garrettsworkshop/RAMSIMM-30/GW4191-4MB-parity-SOP/Documentation/RearIsom.png

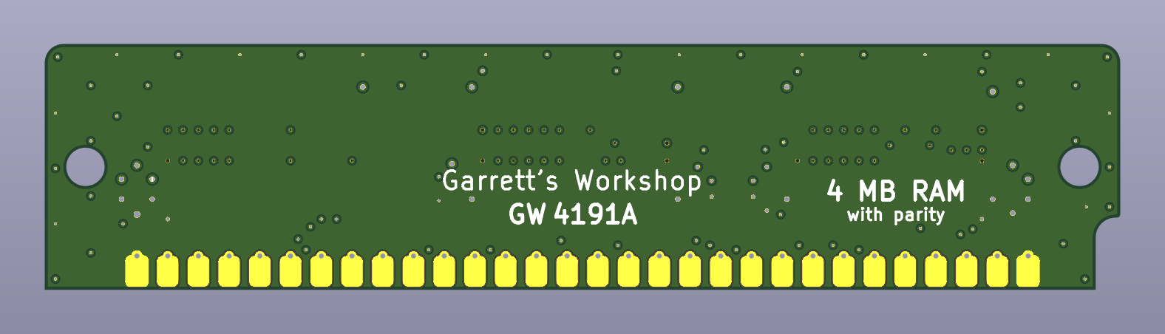
GW4191-4MB-parity-SOP/Documentation/RearIsom.png
