garrettsworkshop/RAMSIMM-30/GW4194-4MB-CBRFIX-SOJ-DP/Documentation/BackIsom.png

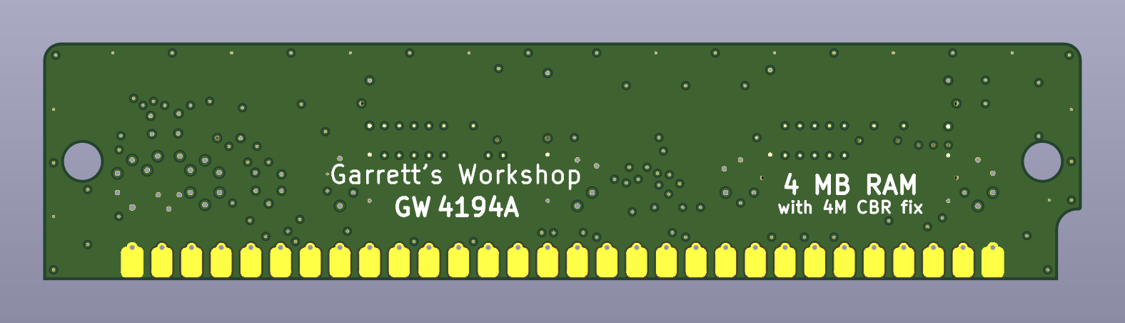
GW4194-4MB-CBRFIX-SOJ-DP/Documentation/BackIsom.png
