garrettsworkshop/RAMSIMM-30/GW4194-4MB-CBRFIX-SOJ-DP/Documentation/FrontIsom.png

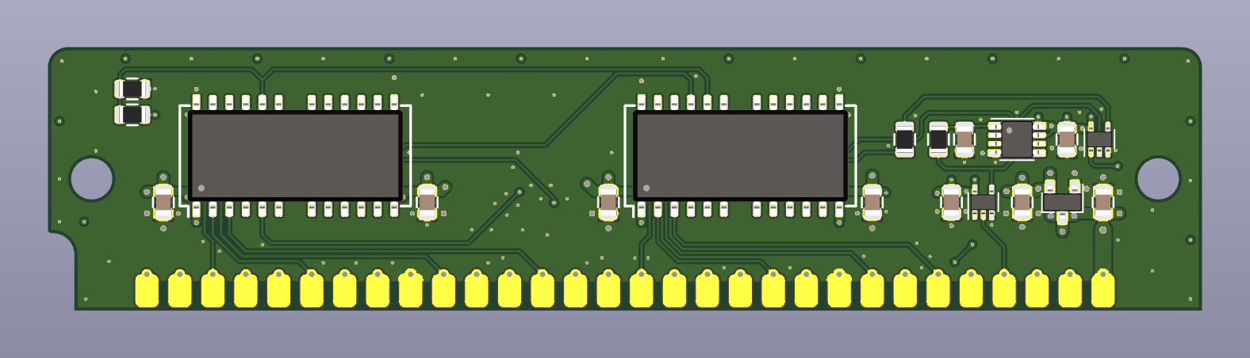
GW4194-4MB-CBRFIX-SOJ-DP/Documentation/FrontIsom.png
