garrettsworkshop/RAMSIMM-30/Documentation/CBR Fix.png

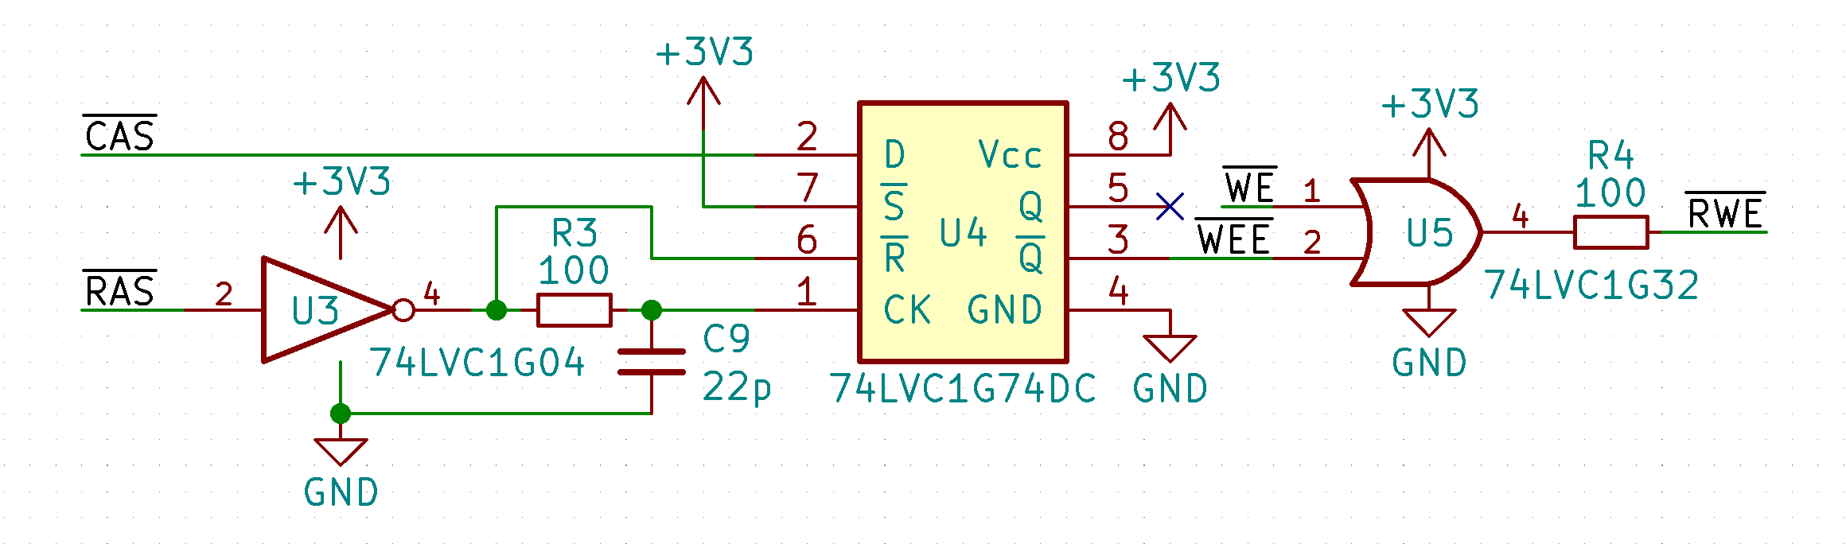
Documentation/CBR Fix.png
