garrettsworkshop/RAMSIMM-30/(threads)

Thread 2 (2022-03-25):

Why some network layer connections do not follow the definition of SIMM pins?

AiGeekNet, 2022-03-25:
I'm trying to print out PIN name on silkscreen layout and copy them from name of network links, and read the history of SIMM from wiki at same time. Then I found there are several different PINs definition just as below:

PIN /  Net Name to IC PINs  / SIMM Definition
==============================
 24 /  1A3            / A11 !!!

 19 /  1A4            / A10 !!!

 18 /  1A5            / A9  !!!

 17 / 1A10            / A8  !!!

 12 /  1A8            / A5  !!!

 11 /  1A9            / A4  !!!

  8 /  1A11           / A3  !!!

Anythings wrong?

AiGeekNet, 2022-04-01:
So mysterious. Is there any good book to learn the complete design specifications and techniques of DRAM modules? I've read a good getting started guide online (https://arstechnica.com/gadgets/2000/07/ram-guide-part1-1/) and would love to dig into some more ^&^

Thread 3 (2022-04-01):

How about higher speed ICs onboard?

AiGeekNet, 2022-04-01:
The ICs I ordered for the first set of four 16MB prototype module is on the way. I can just get 60ns ICs for lowest price, and I just wondered does it work correctly? If I wanna try higher speed ICs such as 50ns, 45ns or 40ns, how much improvement work is needed for these designs of spec?
