garrettsworkshop/RAMSIMM-30/GW4194-4MB-CBRFIX-SOJ-DC/Documentation/Schematic.pdf

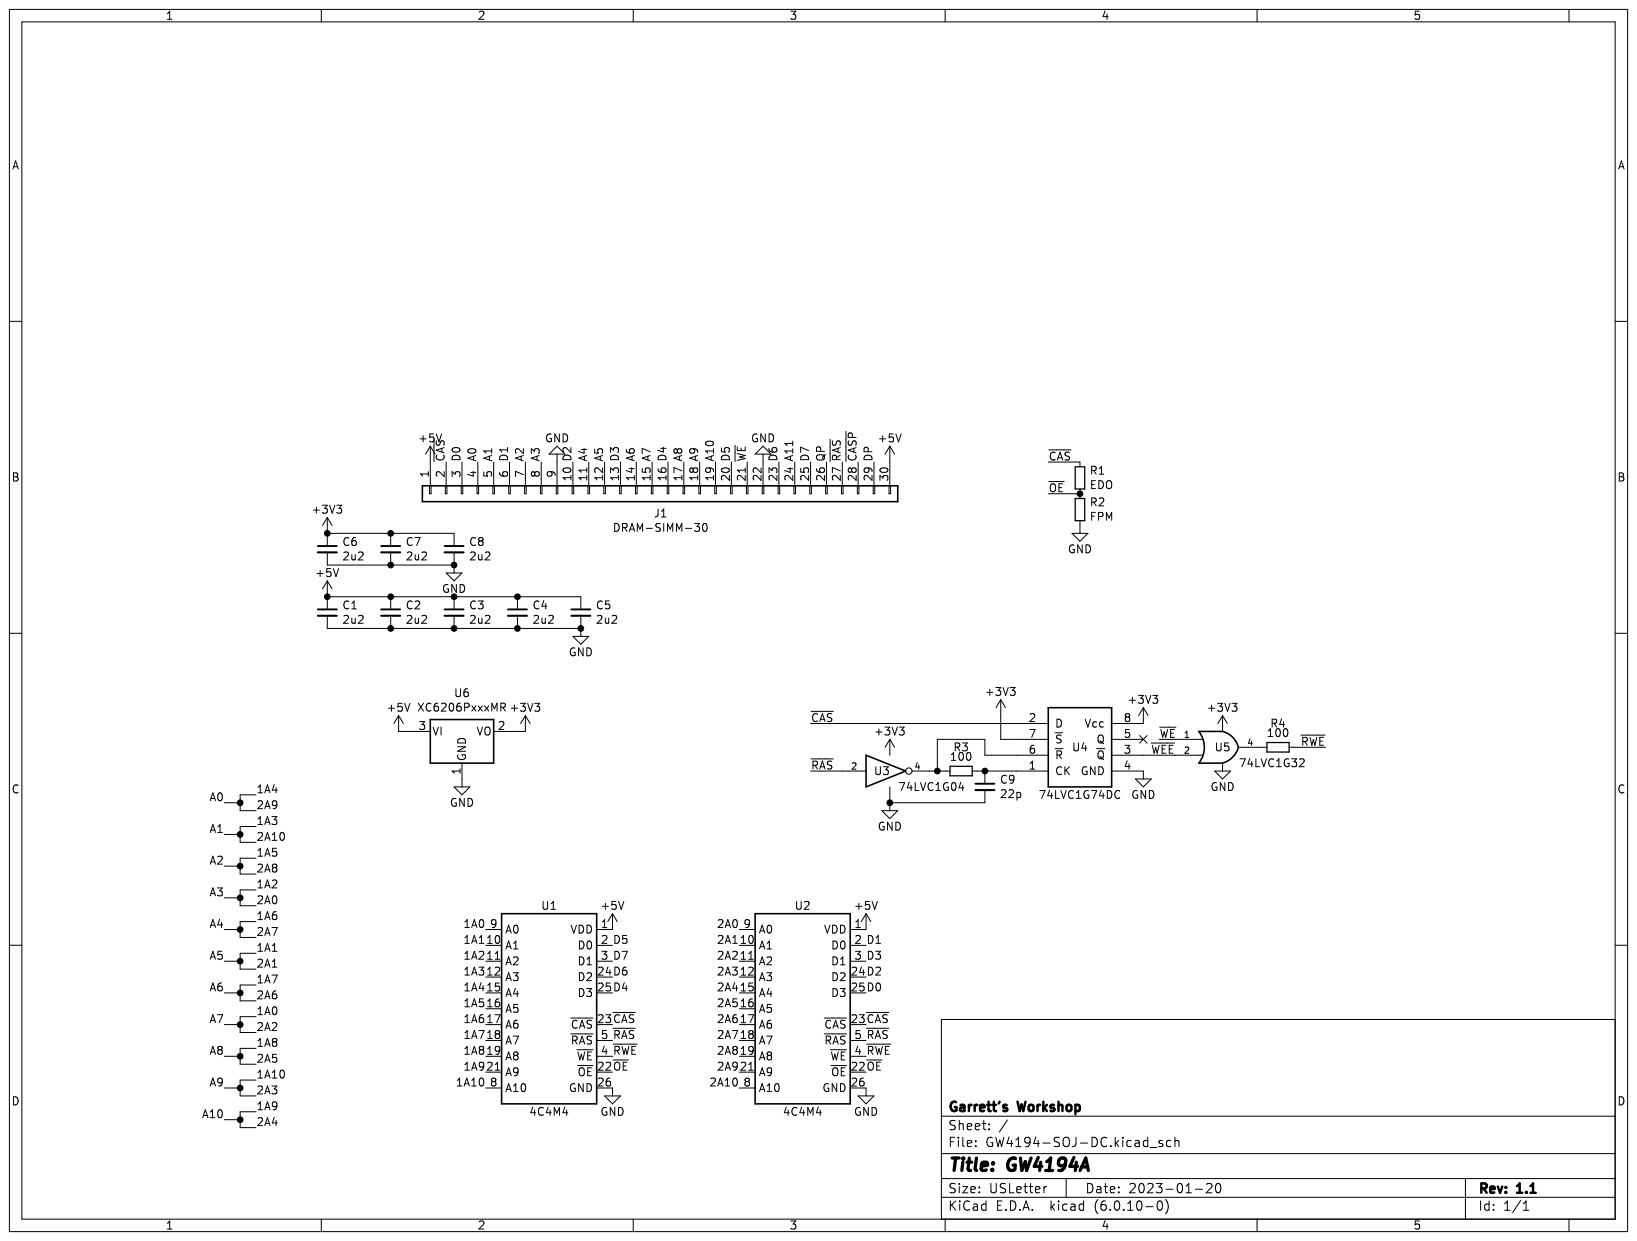
[picture p8: page 1]
