garrettsworkshop/RAMSIMM-30/GW4194-4MB-CBRFIX-SOJ-DP/Documentation/Schematic.pdf

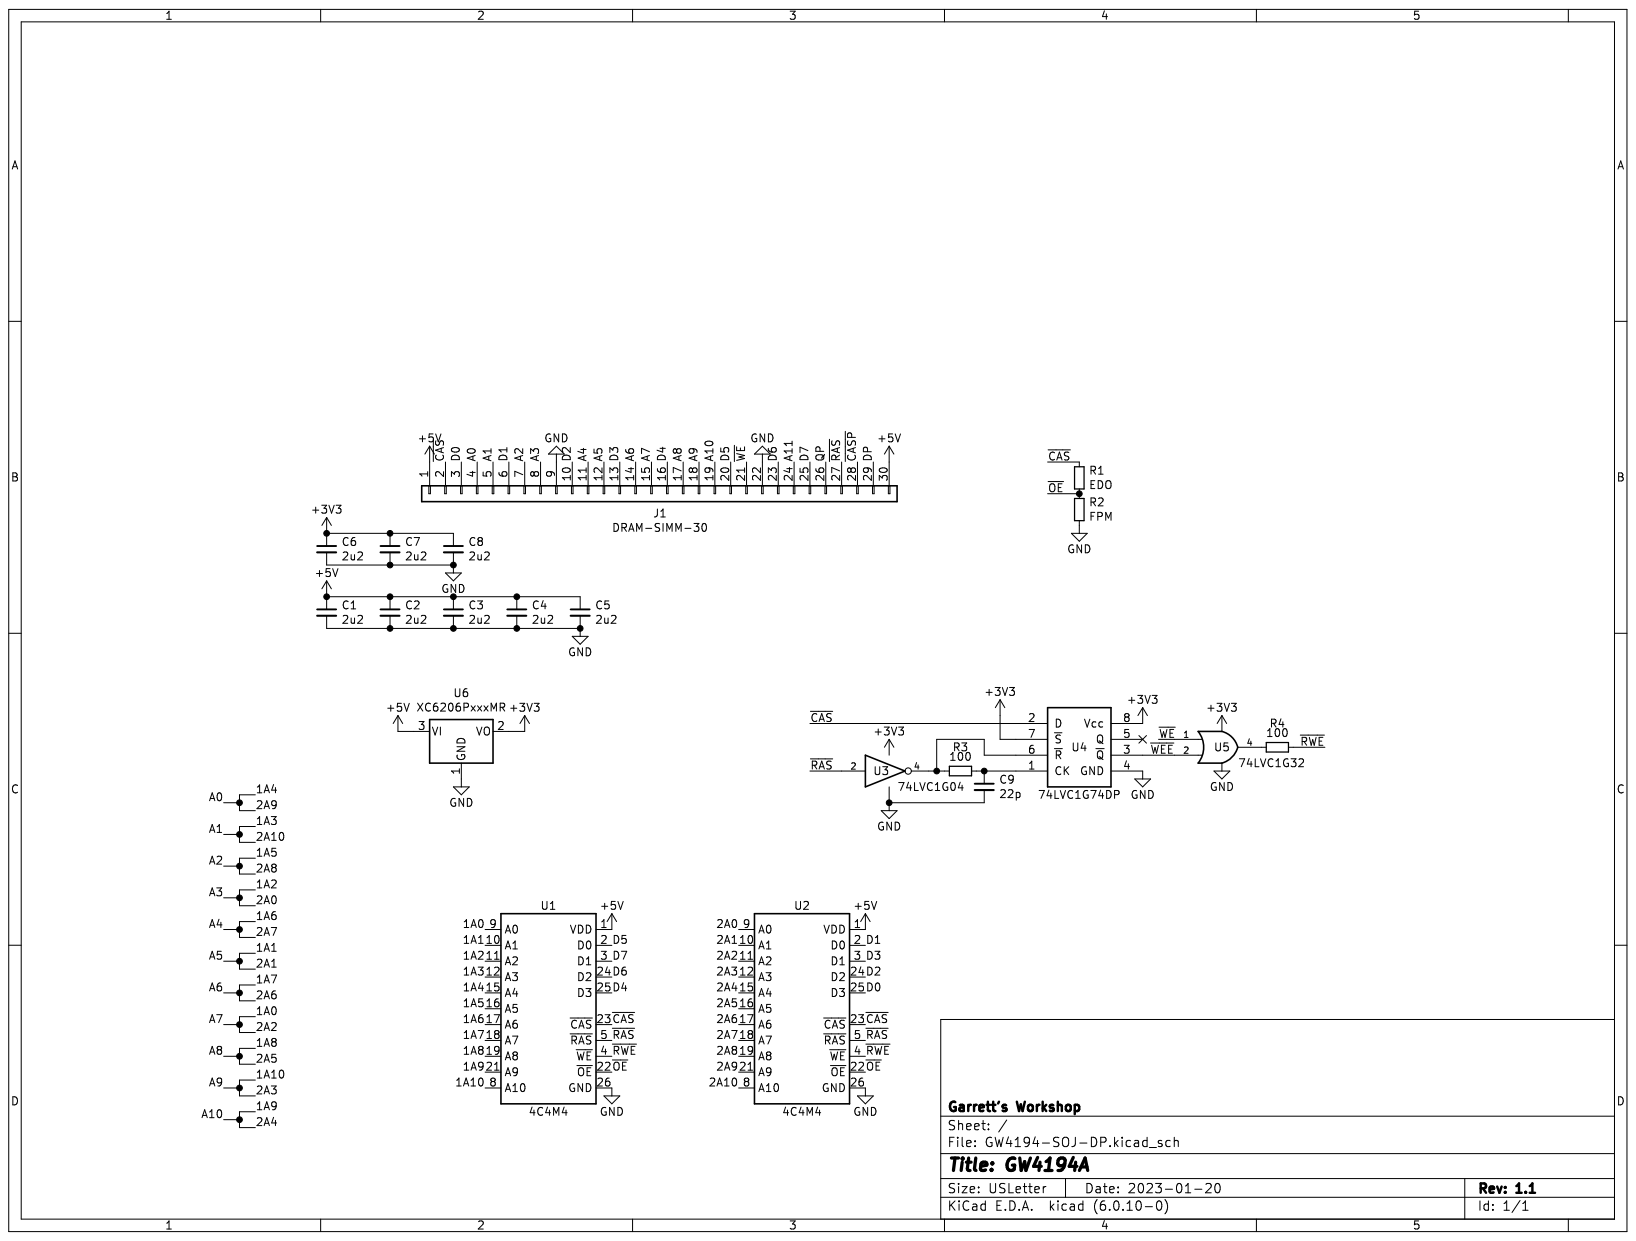
[picture p9: page 1]
