garrettsworkshop/RAMSIMM-30/GW4194-4MB-CBRFIX-SOJ-DC/Documentation/Placement.pdf

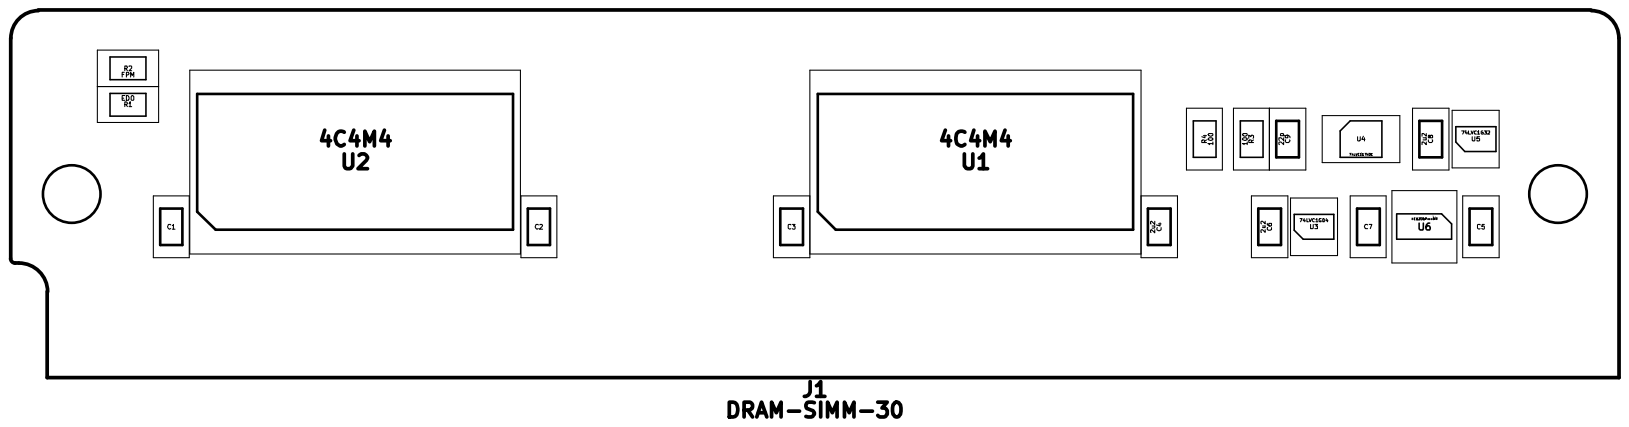
[picture p10: page 1]
