garrettsworkshop/RAMSIMM-30/GW4194-4MB-CBRFIX-SOJ-DP/Documentation/Placement.pdf

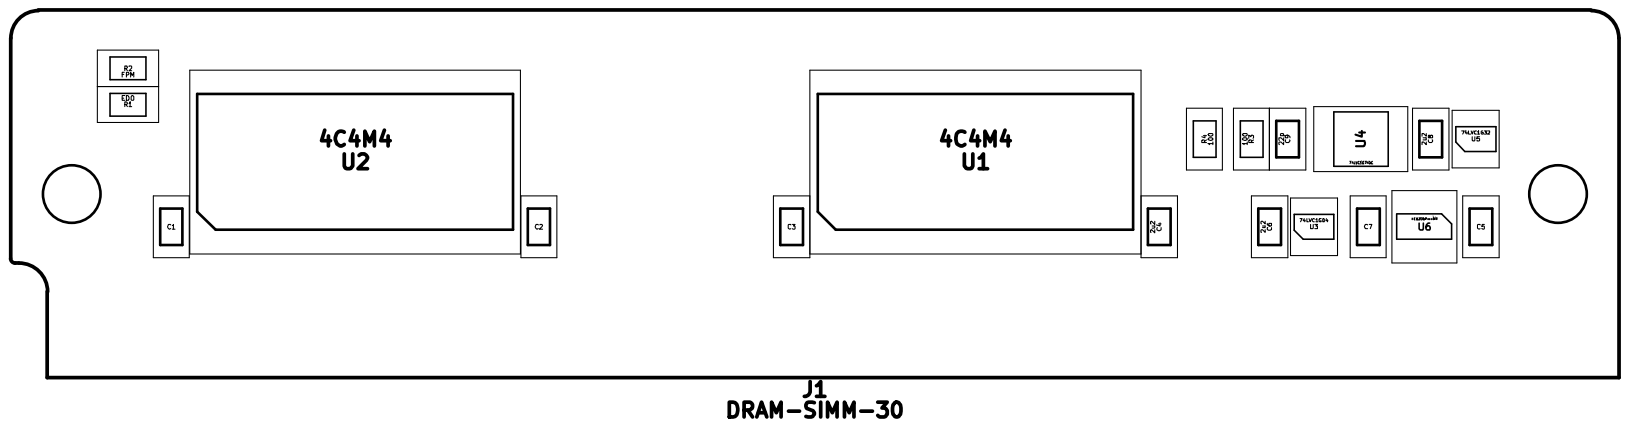
[picture p11: page 1]
