garrettsworkshop/RAMSIMM-30/GW4190-4MB-SOJ/Documentation/Schematic.pdf

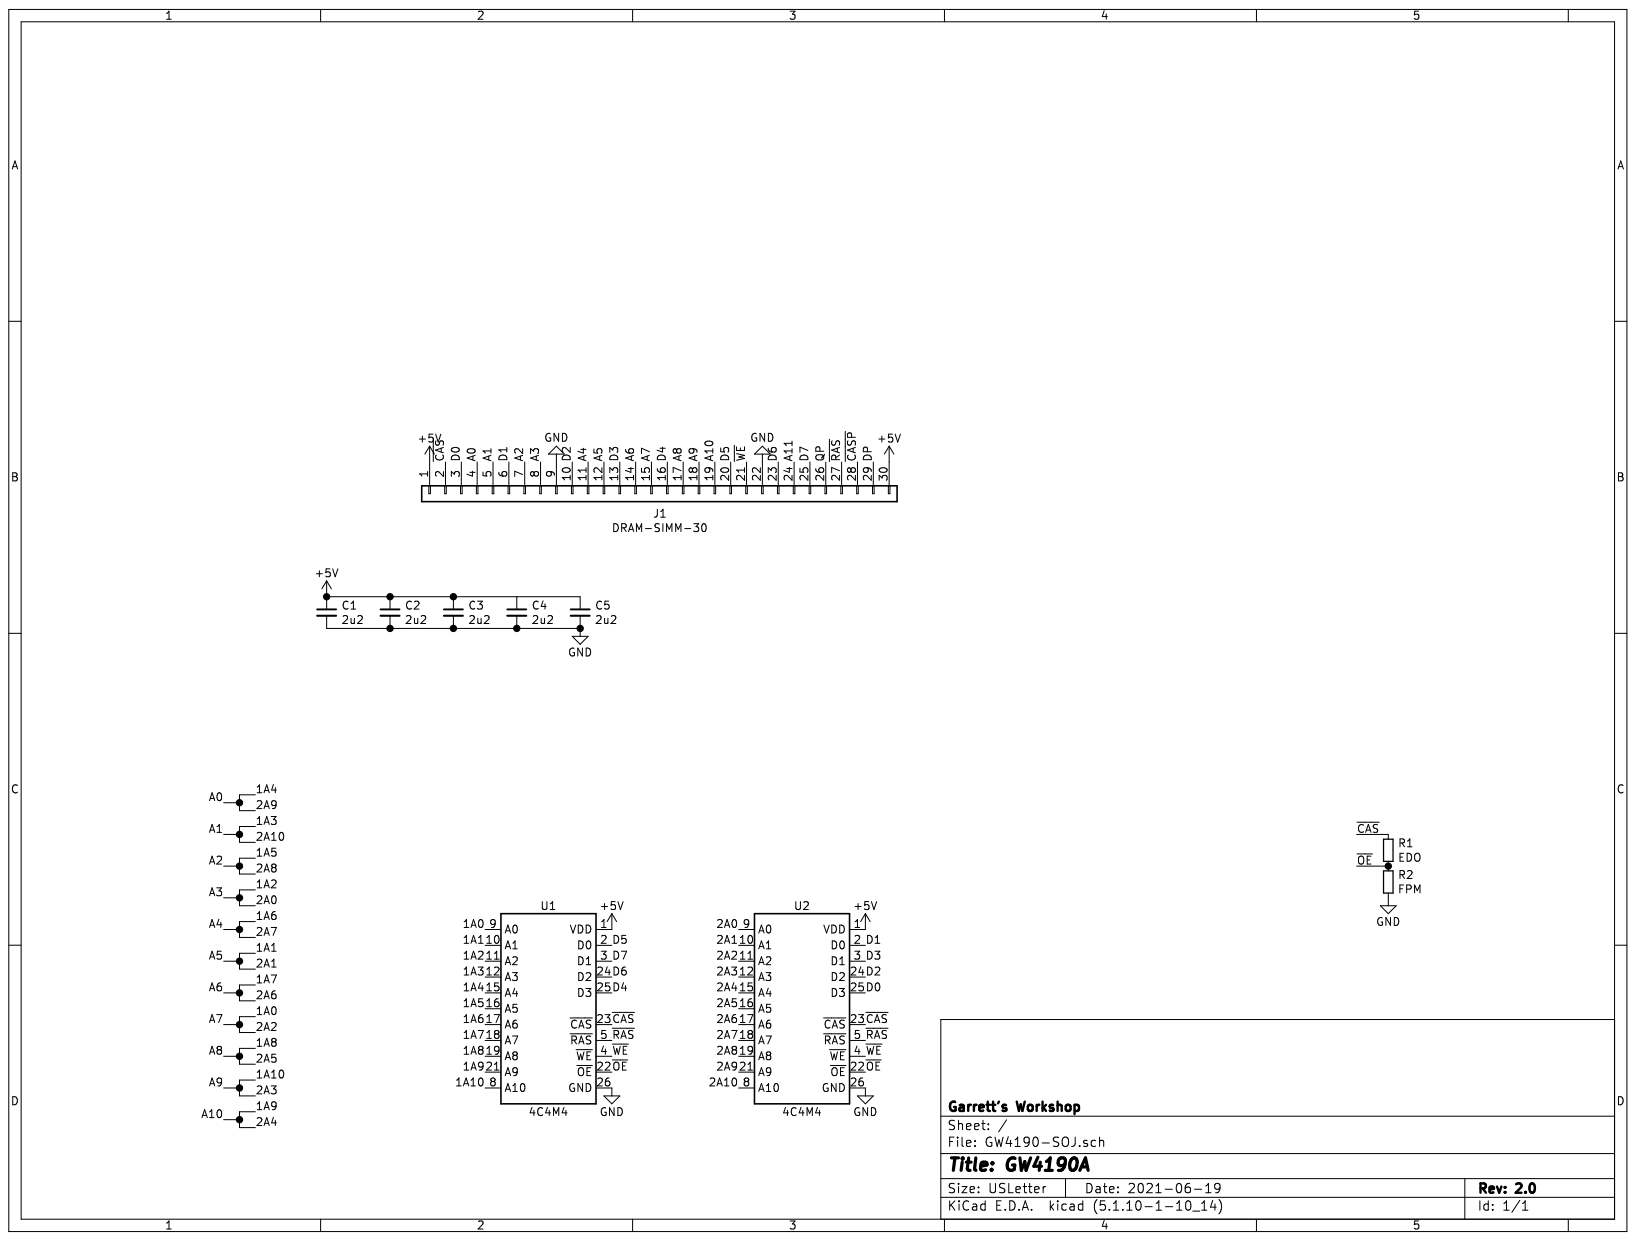
[picture p12: page 1]
