garrettsworkshop/RAMSIMM-30/GW4190-4MB-SOP/Documentation/Schematic.pdf

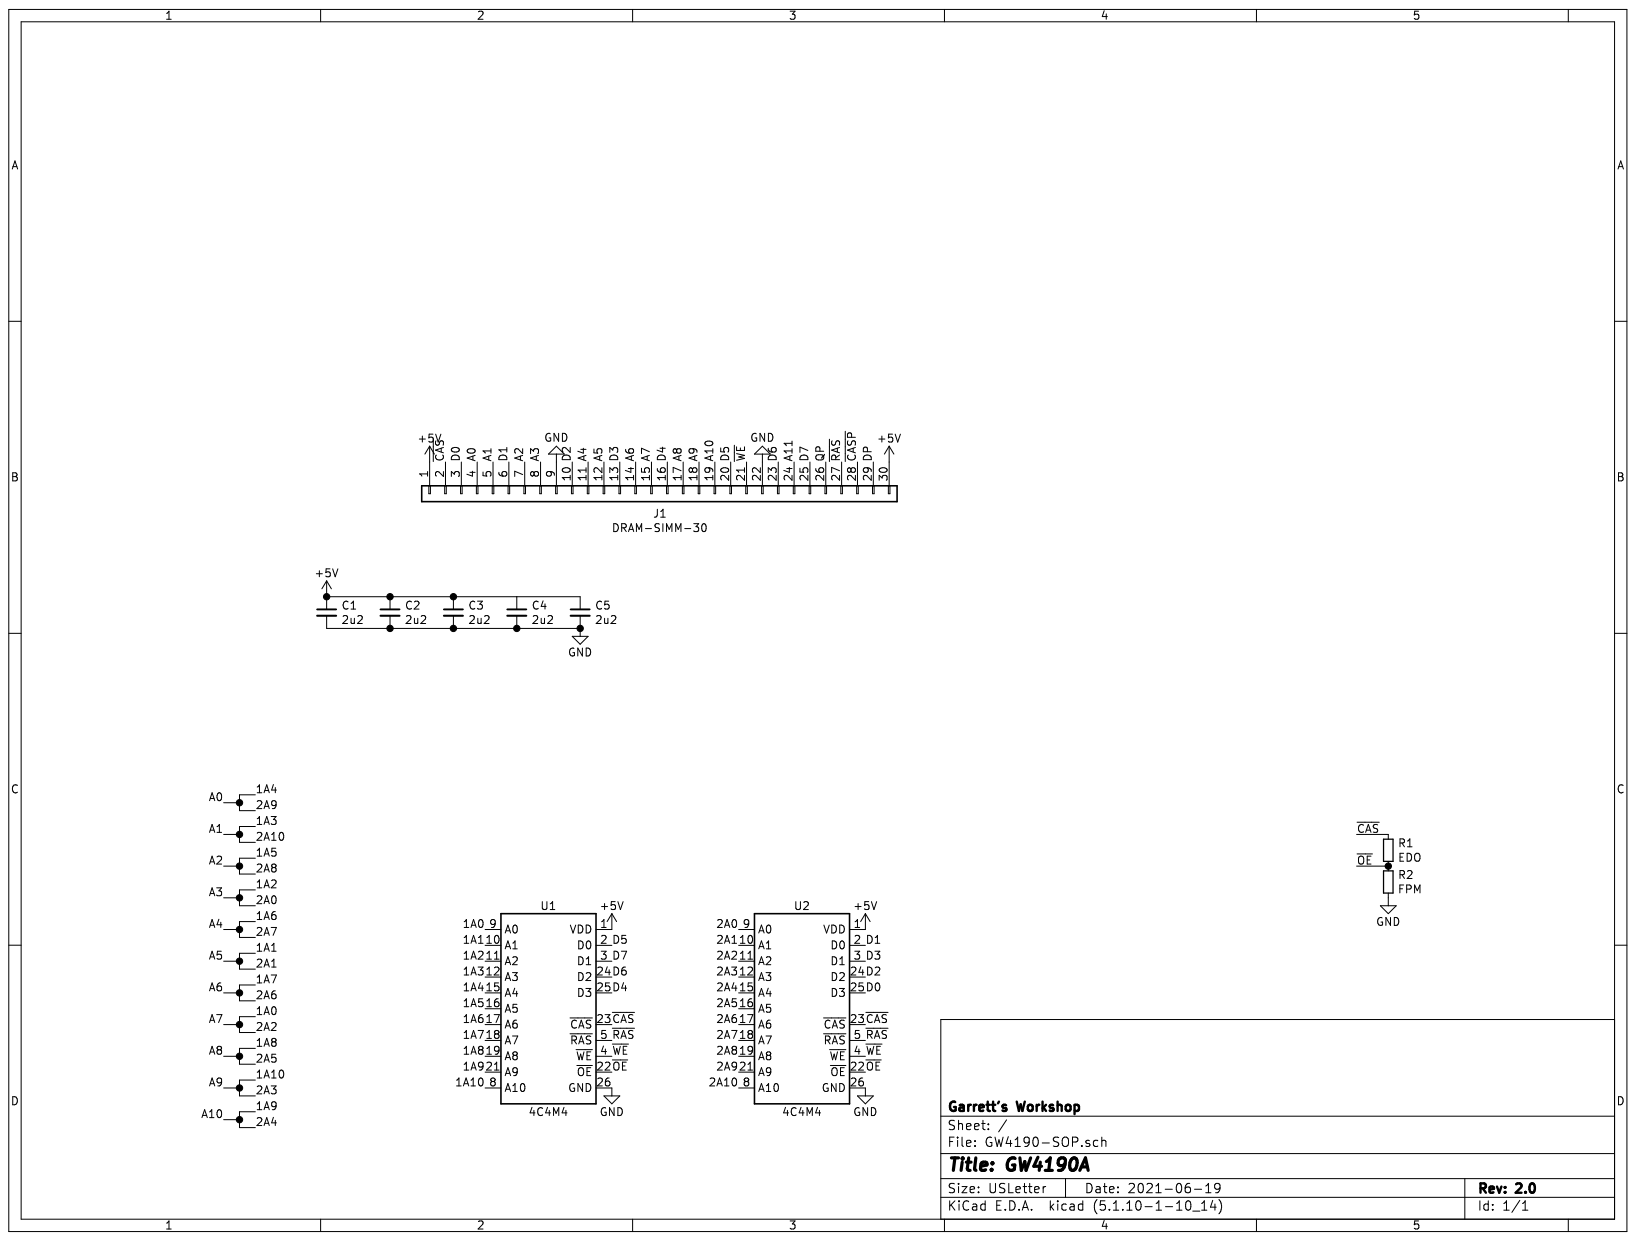
[picture p13: page 1]
