garrettsworkshop/RAMSIMM-30/GW4191-4MB-parity-SOJ/Documentation/Schematic.pdf

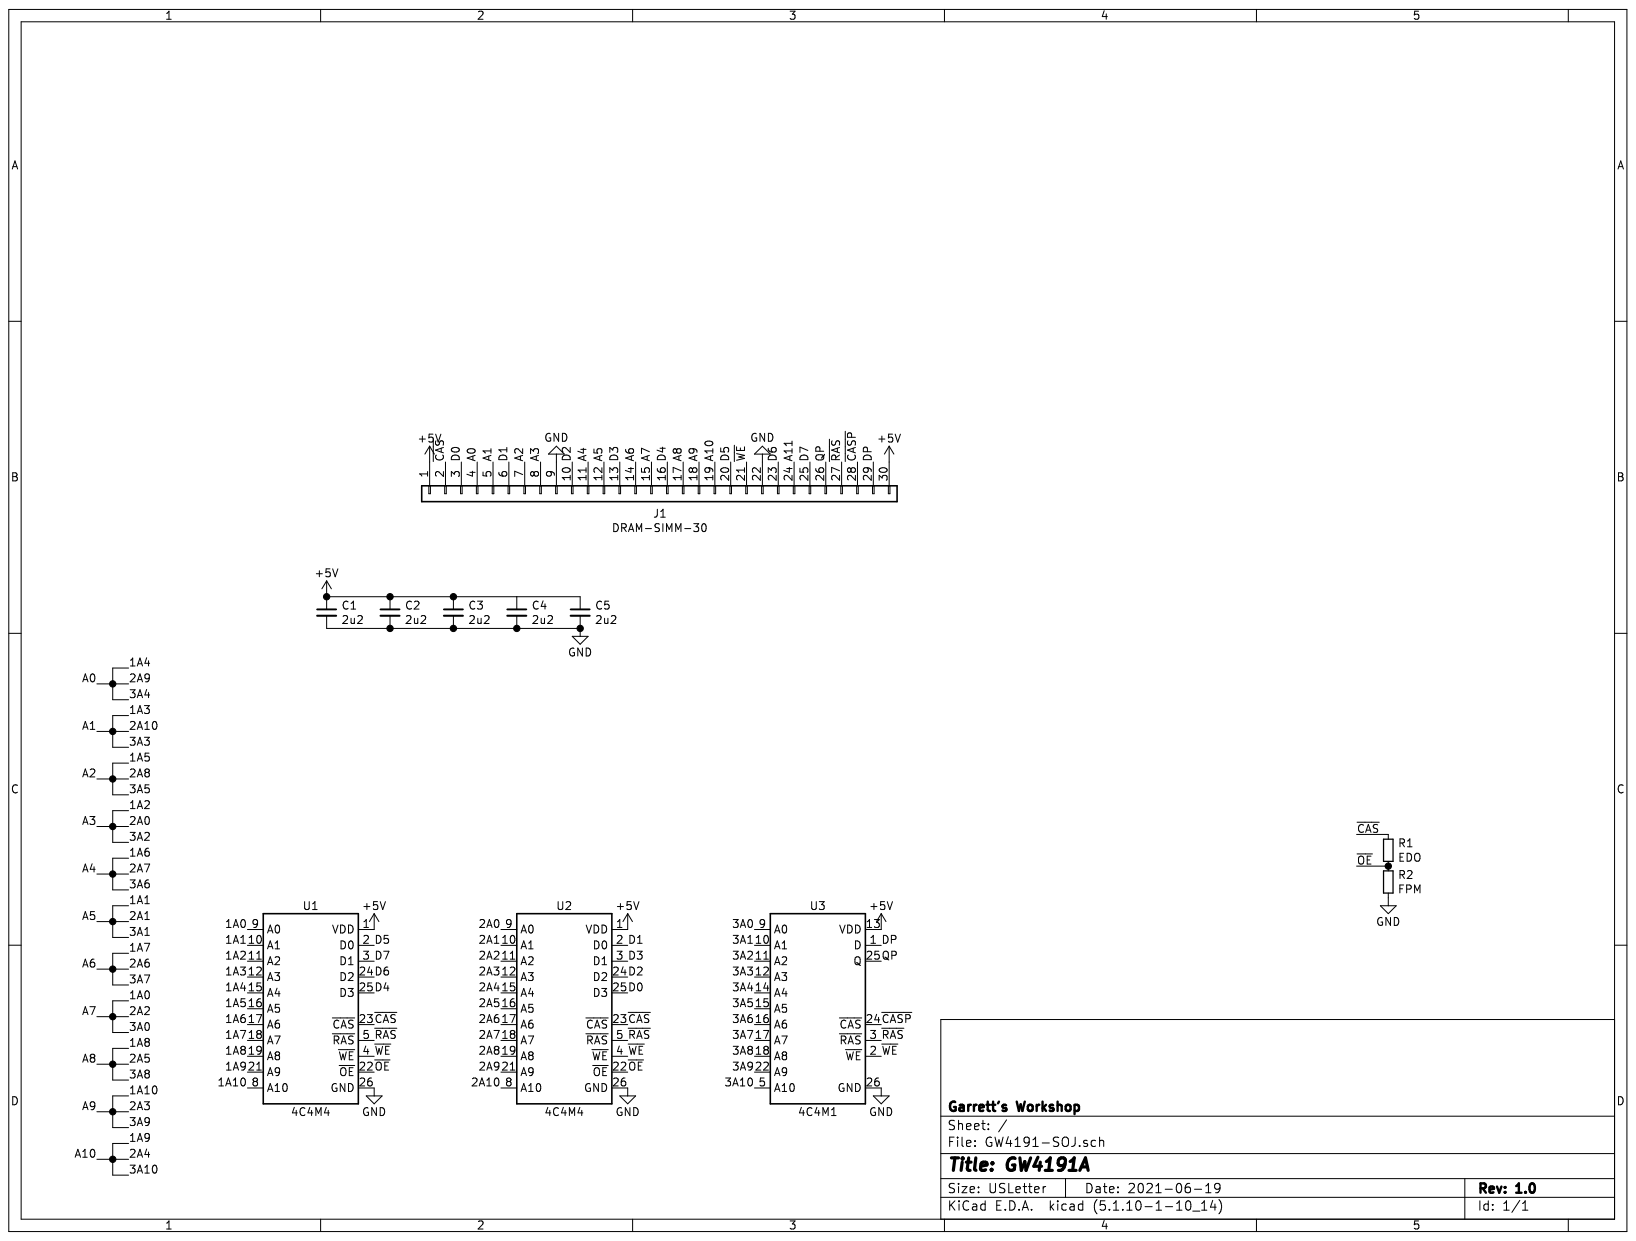
[picture p14: page 1]
