garrettsworkshop/RAMSIMM-30/GW4191-4MB-parity-SOP/Documentation/Schematic.pdf

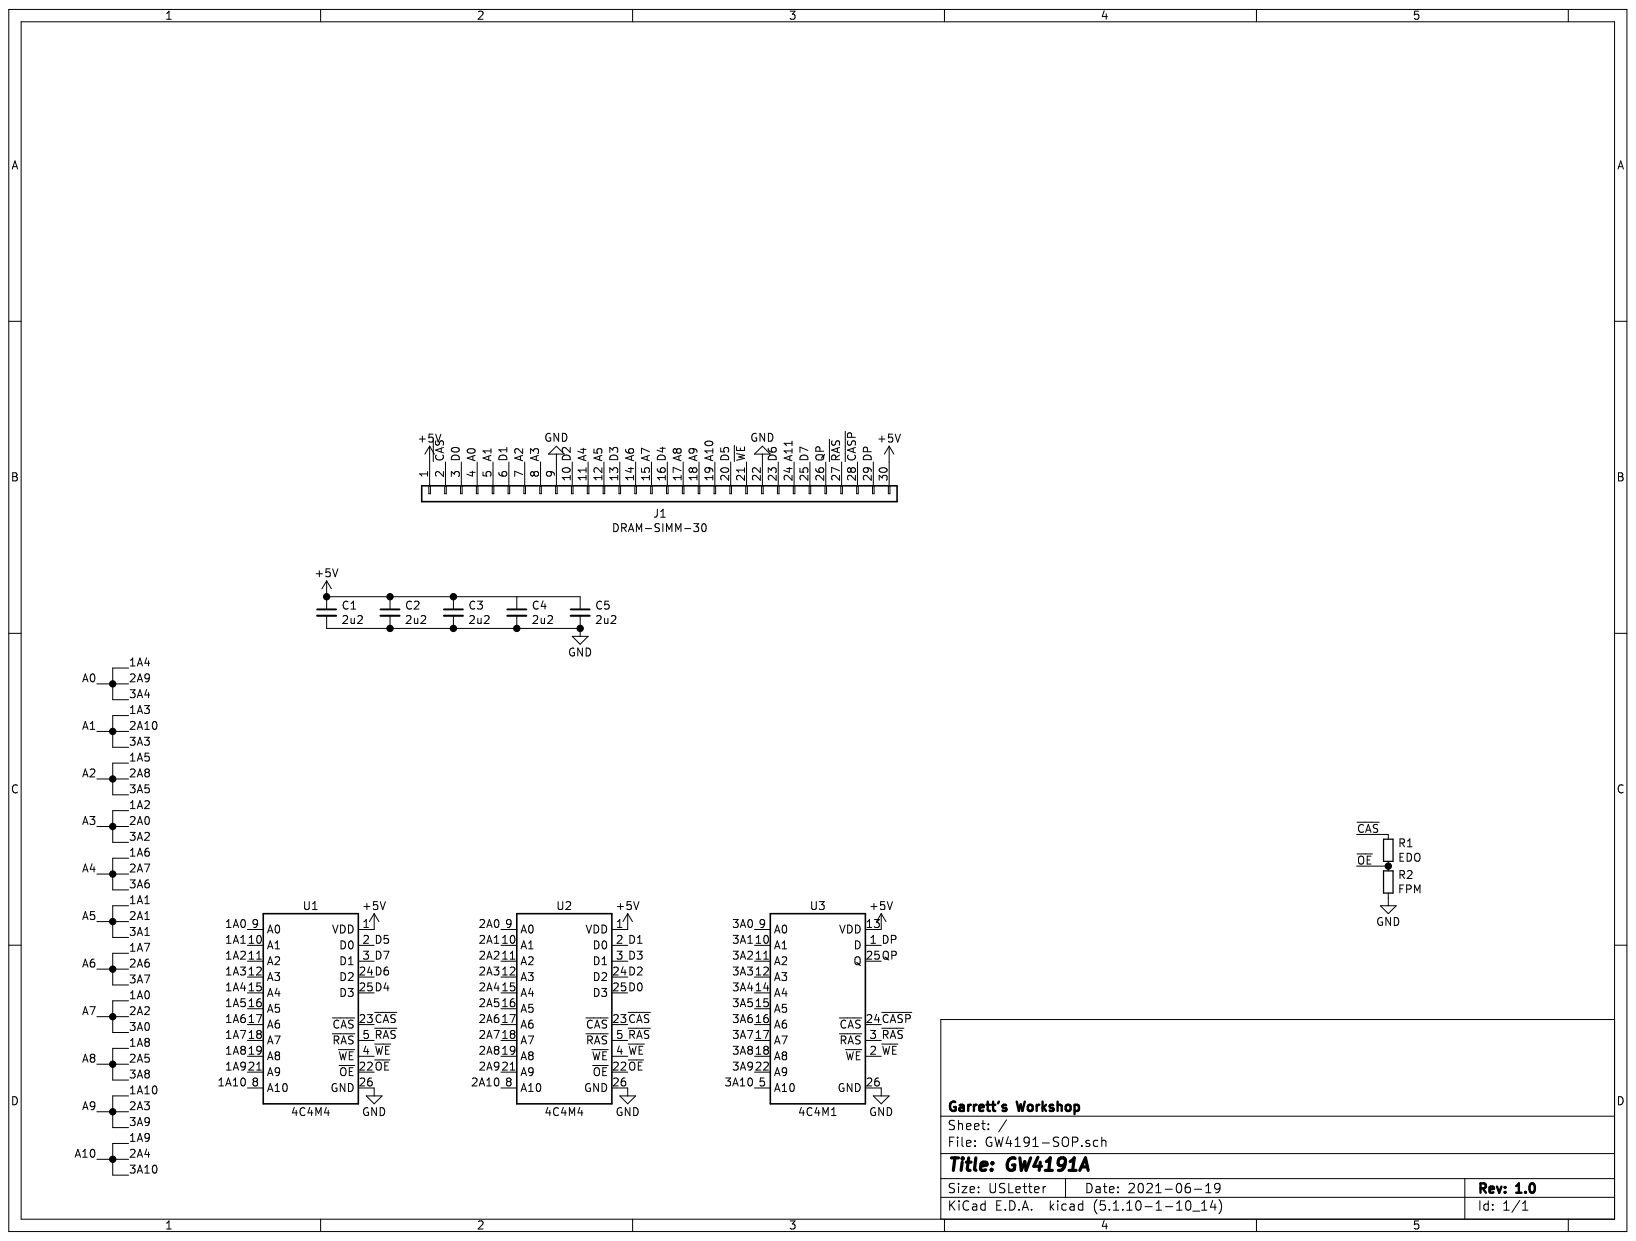
[picture p15: page 1]
