garrettsworkshop/RAMSIMM-30/GW4192-16MB-SOJ/Documentation/Schematic.pdf

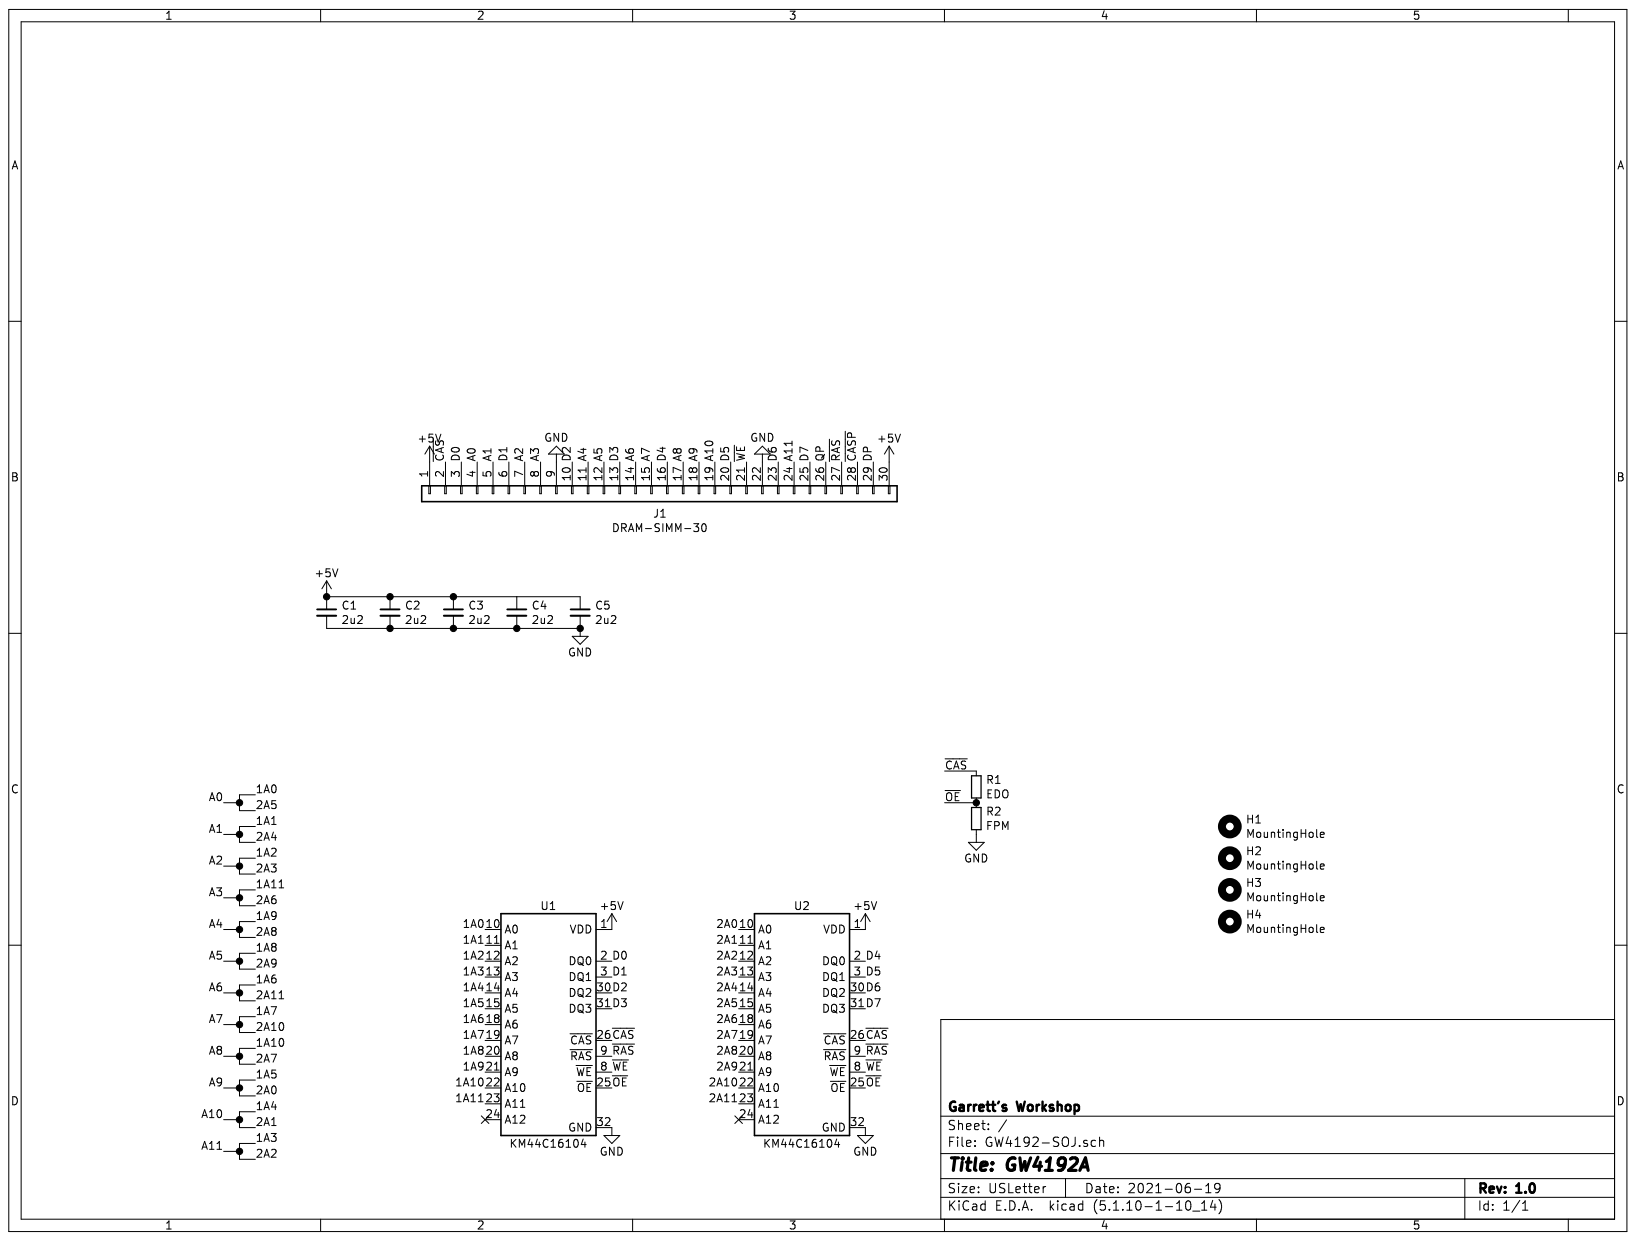
[picture p16: page 1]
