garrettsworkshop/RAMSIMM-30/GW4192-16MB-SOP/Documentation/Schematic.pdf

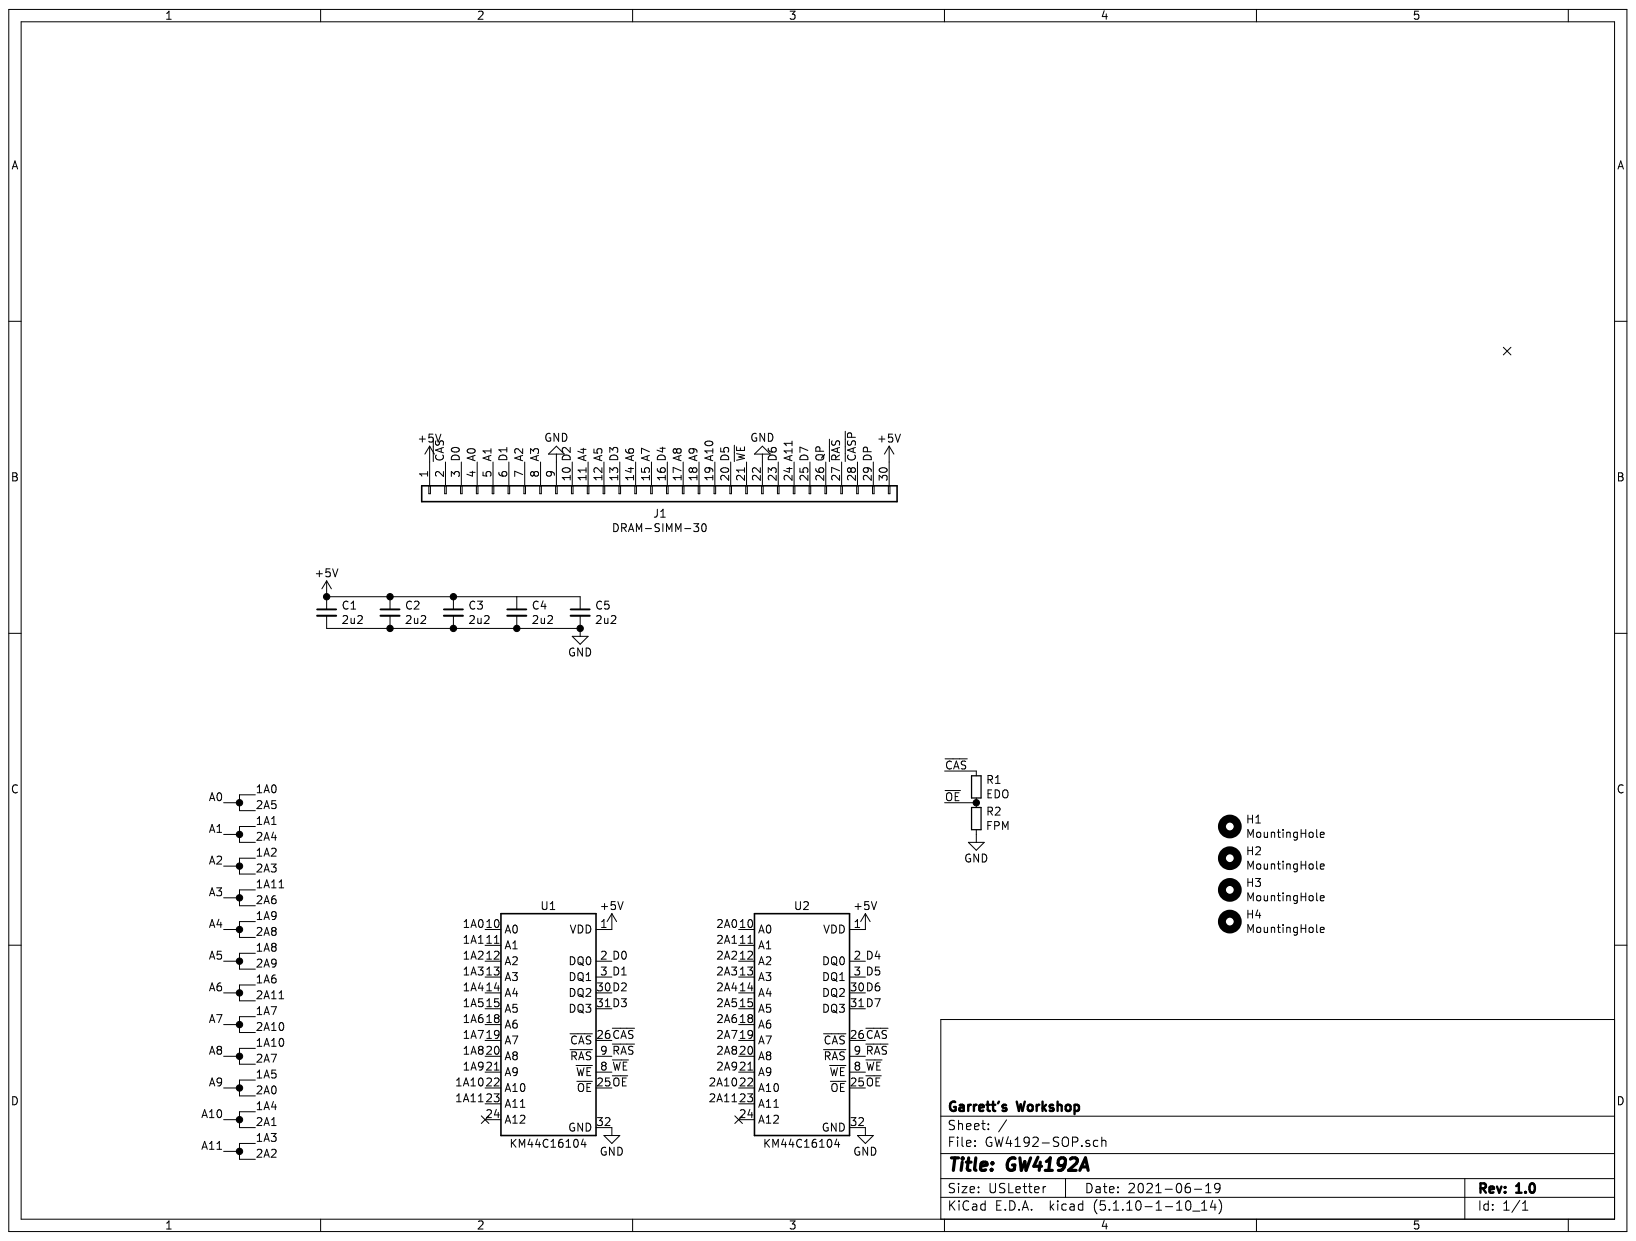
[picture p17: page 1]
