garrettsworkshop/RAMSIMM-30/GW4194-4MB-CBRFIX-SOP/Documentation/Schematic.pdf

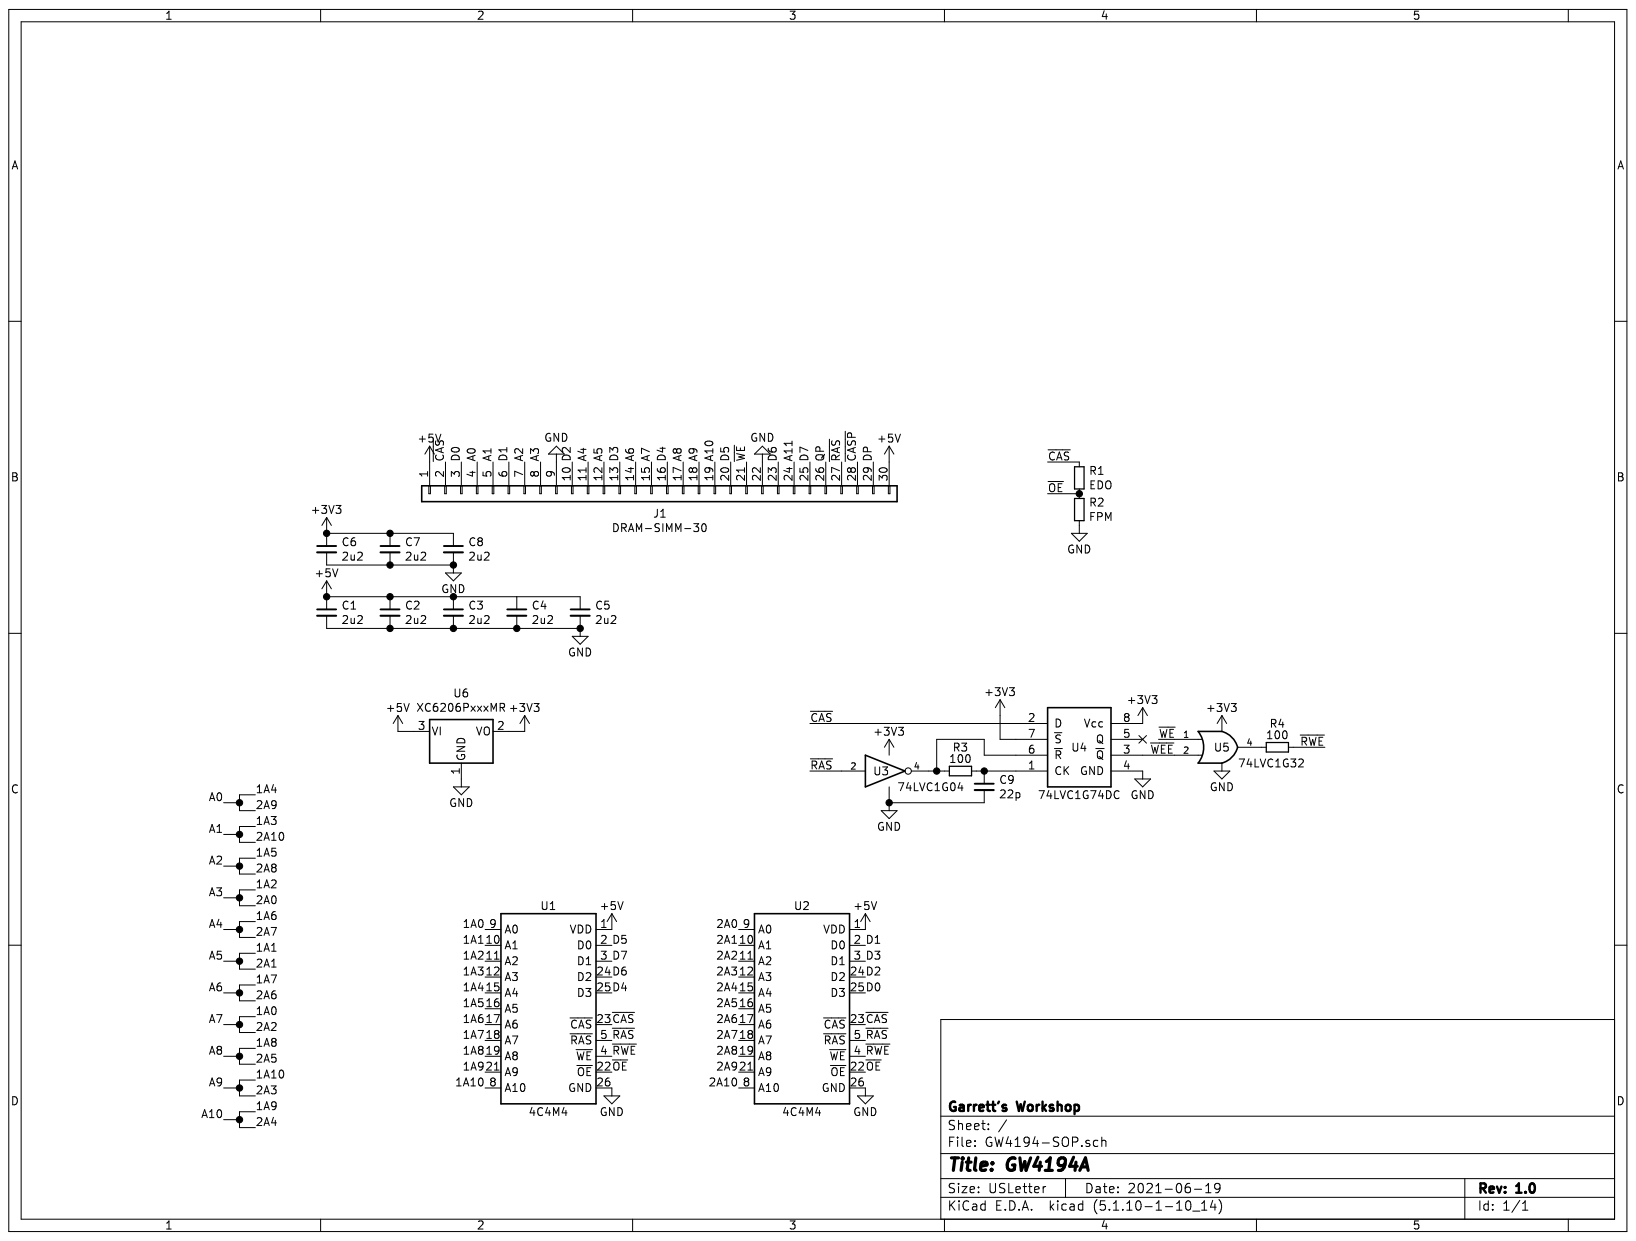
[picture p18: page 1]
