garrettsworkshop/RAMSIMM-30/GW4190-4MB-SOJ/Documentation/Placement.pdf

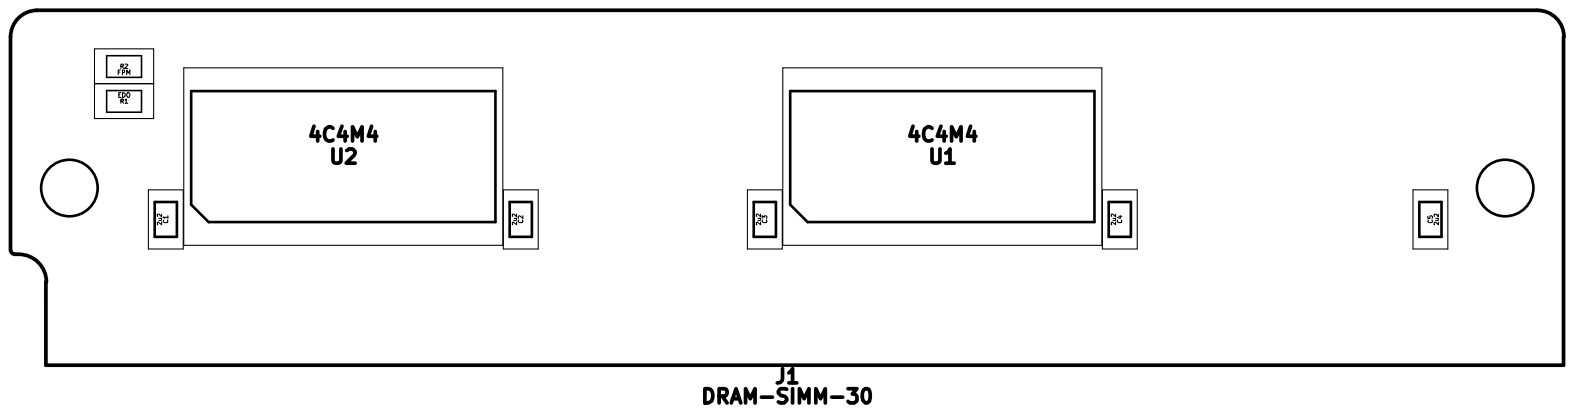
[picture p19: page 1]
