garrettsworkshop/RAMSIMM-30/GW4190-4MB-SOP/Documentation/Placement.pdf

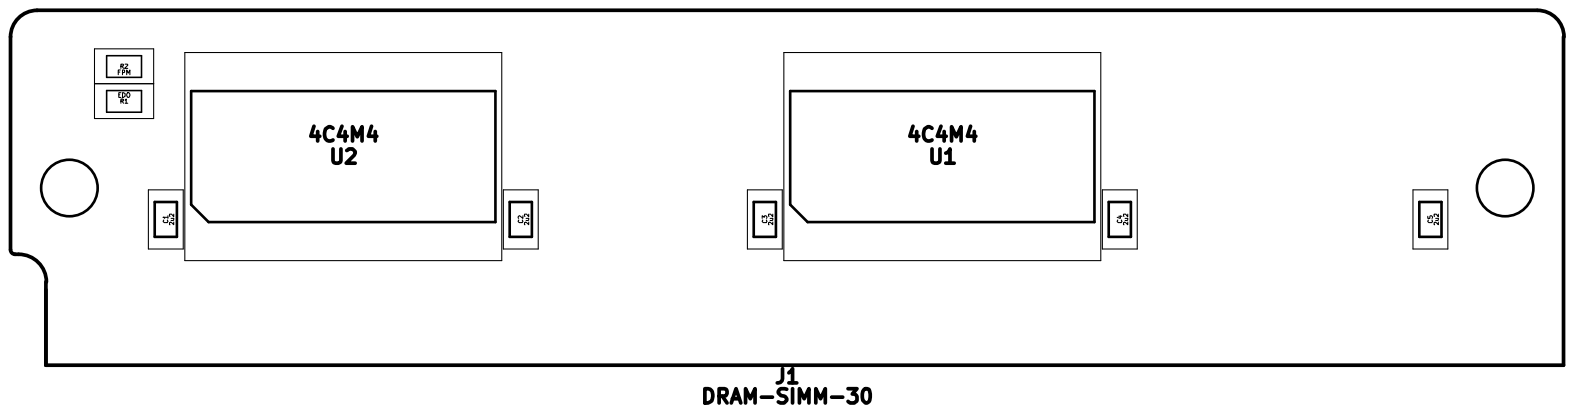
[picture p20: page 1]
