garrettsworkshop/RAMSIMM-30/GW4191-4MB-parity-SOJ/Documentation/Placement.pdf

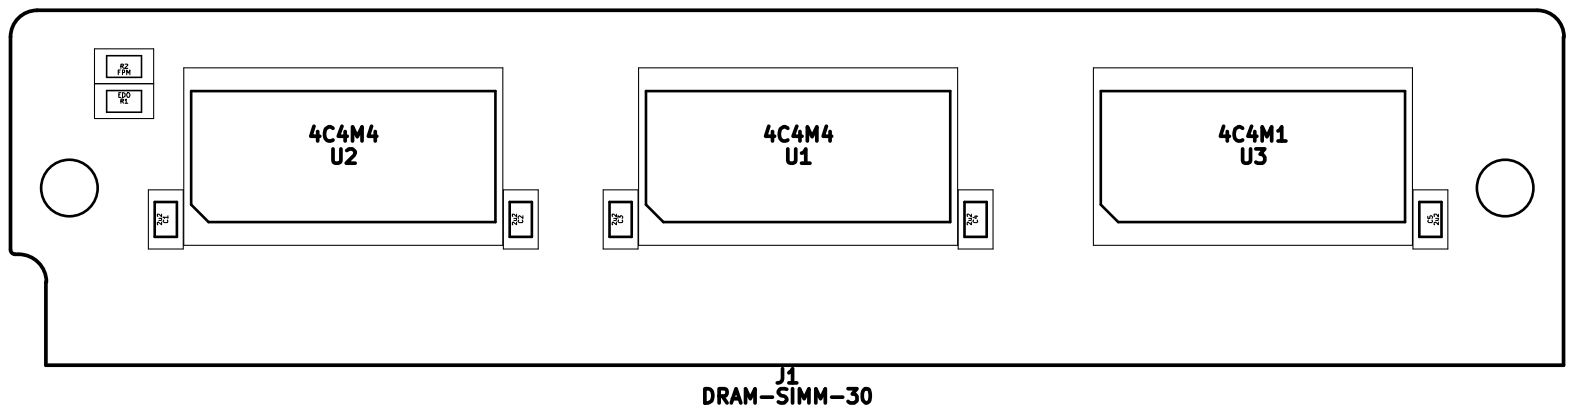
[picture p21: page 1]
