garrettsworkshop/RAMSIMM-30/GW4191-4MB-parity-SOP/Documentation/Placement.pdf

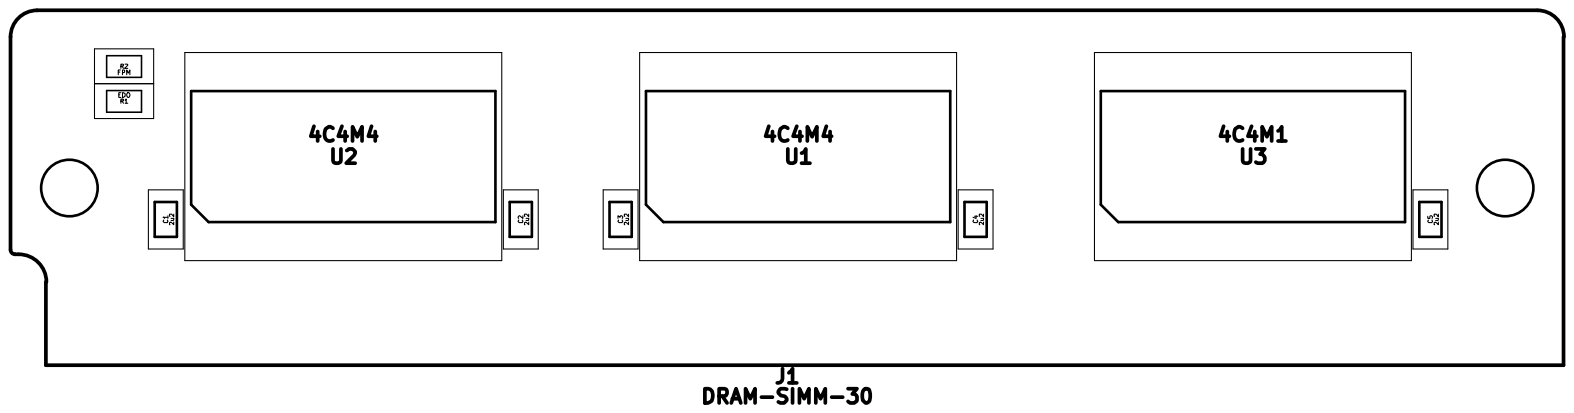
[picture p22: page 1]
