garrettsworkshop/RAMSIMM-30/GW4192-16MB-SOJ/Documentation/Placement.pdf

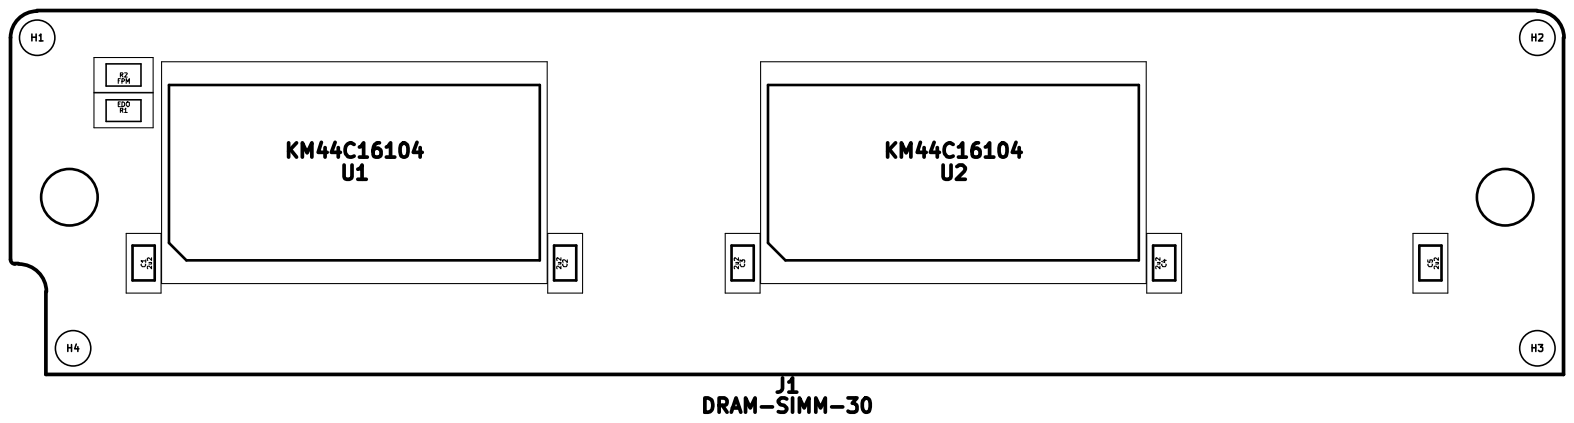
[picture p23: page 1]
