garrettsworkshop/RAMSIMM-30/GW4192-16MB-SOP/Documentation/Placement.pdf

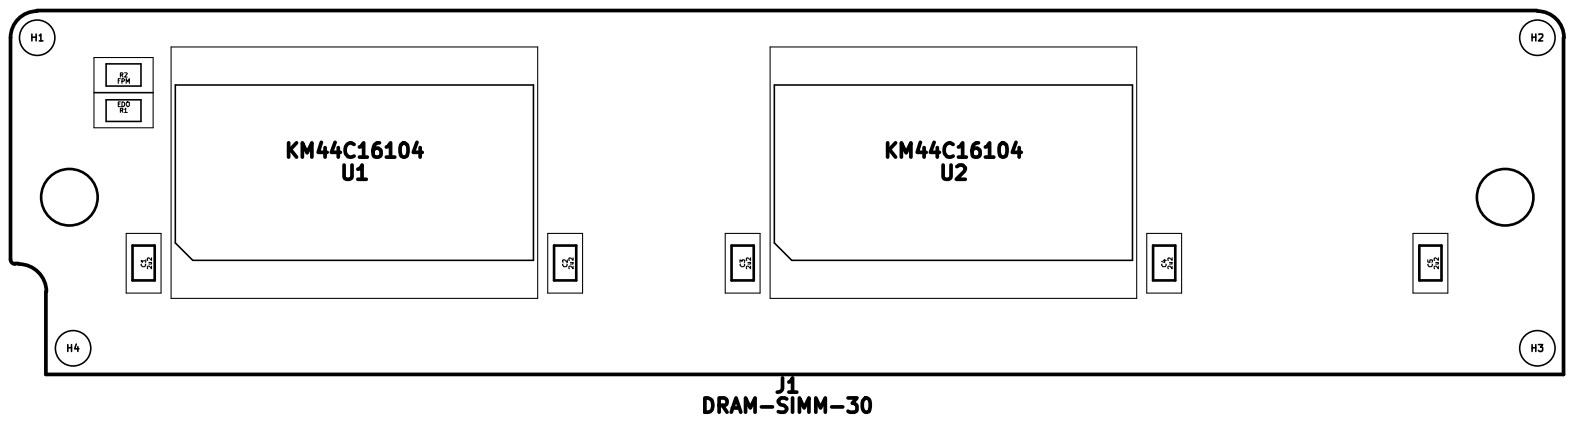
[picture p24: page 1]
