garrettsworkshop/RAMSIMM-30/GW4194-4MB-CBRFIX-SOP/Documentation/Placement.pdf

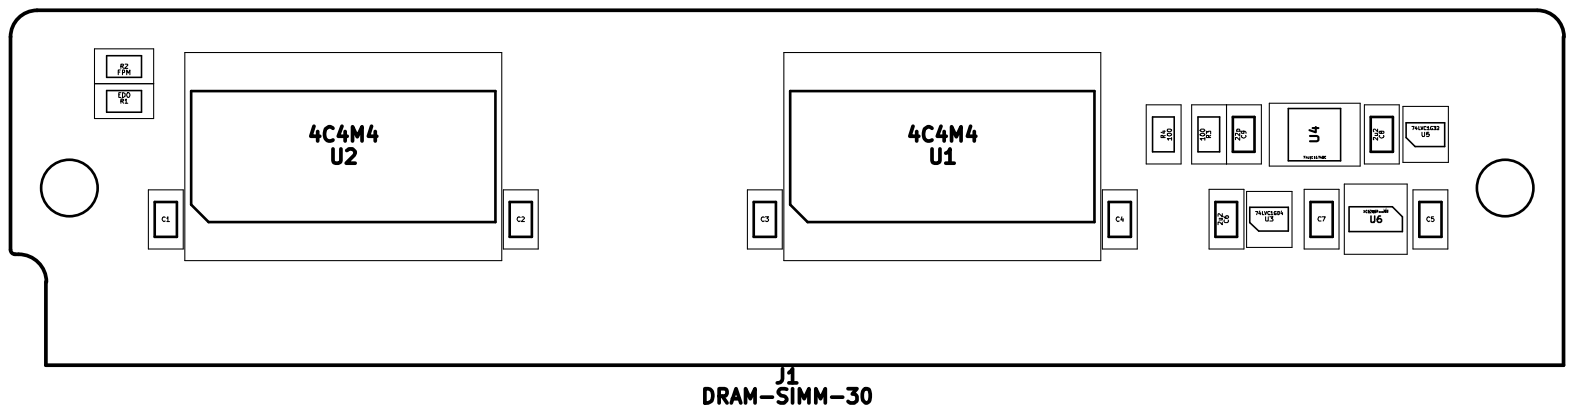
[picture p25: page 1]
