garrettsworkshop/RAMSIMM-30/(commit log)

2019-01-04 lot of work on layout
    [simm-30-4mb.kicad_pcb, simm-30-4mb.sch]
2019-04-27 more work
    [simm-30-4mb.kicad_pcb, simm-30-4mb.sch]
2019-06-10 changed a lot
    [simm-30-4mb.kicad_pcb, simm-30-4mb.sch]
2019-06-26 Finished routing. Now need to do the board outline more
    [simm-30-4mb.kicad_pcb, simm-30-4mb.sch]
2019-07-30 Submitted to JLCPCB
    [simm-30-4mb-B_Cu.gbl, simm-30-4mb-B_Mask.gbs, simm-30-4mb-B_SilkS.gbo, simm-30-4mb-Edge_Cuts.gm1, simm-30-4mb-F_Cu.gtl, simm-30-4mb-F_Mask.gts, simm-30-4mb-F_Paste.gtp, simm-30-4mb-F_SilkS.gto]
2020-05-15 Added back and front isometric renders
    [simm-30-4mb.kicad_pcb]
2020-05-15 Removed JLCJLCJLC
    [simm-30-4mb-B_Cu.gbl, simm-30-4mb-B_Mask.gbs, simm-30-4mb-B_SilkS.gbo, simm-30-4mb-Edge_Cuts.gm1, simm-30-4mb-F_Cu.gtl, simm-30-4mb-F_Mask.gts, simm-30-4mb-F_Paste.gtp, simm-30-4mb-F_SilkS.gto]
2020-05-15 Changed text
    [simm-30-4mb-B_Cu.gbl, simm-30-4mb-B_Mask.gbs, simm-30-4mb-B_SilkS.gbo, simm-30-4mb-Edge_Cuts.gm1, simm-30-4mb-F_Cu.gtl, simm-30-4mb-F_Mask.gts, simm-30-4mb-F_Paste.gtp, simm-30-4mb-F_SilkS.gto]
2020-05-15 Cleaned up board a little
    [simm-30-4mb-B_Cu.gbl, simm-30-4mb-B_Mask.gbs, simm-30-4mb-B_SilkS.gbo, simm-30-4mb-Edge_Cuts.gm1, simm-30-4mb-F_Cu.gtl, simm-30-4mb-F_Mask.gts, simm-30-4mb-F_Paste.gtp, simm-30-4mb-F_SilkS.gto]
2020-05-15 Extended edge connector pads downward
    [simm-30-4mb-B_Cu.gbl, simm-30-4mb-B_Mask.gbs, simm-30-4mb-B_SilkS.gbo, simm-30-4mb-Edge_Cuts.gm1, simm-30-4mb-F_Cu.gtl, simm-30-4mb-F_Mask.gts, simm-30-4mb-F_Paste.gtp, simm-30-4mb-F_SilkS.gto]
2020-05-15 Flood power edge connector pins
    [simm-30-4mb-B_Cu.gbl, simm-30-4mb-B_Mask.gbs, simm-30-4mb-B_SilkS.gbo, simm-30-4mb-Edge_Cuts.gm1, simm-30-4mb-F_Cu.gtl, simm-30-4mb-F_Mask.gts, simm-30-4mb-F_Paste.gtp, simm-30-4mb-F_SilkS.gto]
2020-05-16 Rounded corners
    [simm-30-4mb-B_Cu.gbl, simm-30-4mb-B_Mask.gbs, simm-30-4mb-B_SilkS.gbo, simm-30-4mb-Edge_Cuts.gm1, simm-30-4mb-F_Cu.gtl, simm-30-4mb-F_Mask.gts, simm-30-4mb-F_Paste.gtp, simm-30-4mb-F_SilkS.gto]
2020-05-16 Fixed bug in stitching
    [simm-30-4mb-B_Cu.gbl, simm-30-4mb-B_Mask.gbs, simm-30-4mb-B_SilkS.gbo, simm-30-4mb-Edge_Cuts.gm1, simm-30-4mb-F_Cu.gtl, simm-30-4mb-F_Mask.gts, simm-30-4mb-F_Paste.gtp, simm-30-4mb-F_SilkS.gto]
2020-12-27 Unrounded bottom corners
    [simm-30-4mb-B_Cu.gbl, simm-30-4mb-B_Mask.gbs, simm-30-4mb-B_SilkS.gbo, simm-30-4mb-Edge_Cuts.gm1, simm-30-4mb-F_Cu.gtl, simm-30-4mb-F_Mask.gts, simm-30-4mb-F_Paste.gtp, simm-30-4mb-F_SilkS.gto]
2021-02-26 Taller (20mm height)
    [simm-30-4mb.kicad_pcb]
2021-06-07 Added 16 MB SIMMs
    [simm-30-16mb.kicad_pcb, simm-30-16mb.sch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]
2021-06-07 Some more tweaks
    [simm-30-16mb.kicad_pcb]
2021-06-19 Done with new layouts?
    [simm-30-16mb.kicad_pcb, simm-30-16mb.sch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]
2021-08-03 Fix missing copper area void on rear side edge connector
    [GW4190-SOJ-B_Cu.gbl, GW4190-SOJ-B_Mask.gbs, GW4190-SOJ-B_SilkS.gbo, GW4190-SOJ-Edge_Cuts.gm1, GW4190-SOJ-F_Cu.gtl, GW4190-SOJ-F_Mask.gts, GW4190-SOJ-F_Paste.gtp, GW4190-SOJ-F_SilkS.gto]
2023-01-09 Update to KiCAD 6
    [GW4190-SOJ.kicad_pcb, GW4190-SOJ.kicad_sch, GW4190-SOJ.sch, GW4190-SOP.kicad_pcb, GW4190-SOP.kicad_sch, GW4190-SOP.sch, GW4191-SOJ.kicad_pcb, GW4191-SOJ.kicad_sch]
2023-01-21 Move PAL SIMM SOJ to "DP" directory in prep for "DC" version
    [GW4194-SOJ-DP.kicad_pcb, GW4194-SOJ-DP.kicad_sch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]
2023-02-02 New GW4194A v1.1 with SOJ-VSSOP and SOJ-TSSOP boards.
    (SOP still has only TSSOP)
    [GW4194-SOJ-B_Cu.gbl, GW4194-SOJ-B_Mask.gbs, GW4194-SOJ-B_SilkS.gbo, GW4194-SOJ-DC-B_Cu.gbl, GW4194-SOJ-DC-B_Mask.gbs, GW4194-SOJ-DC-B_Silkscreen.gbo, GW4194-SOJ-DC-Edge_Cuts.gm1, GW4194-SOJ-DC-F_Cu.gtl]
2023-02-28 New SOJ-DC with /WE bypass resistor
    [GW4194-SOJ-DC-B_Cu.gbl, GW4194-SOJ-DC-B_Mask.gbs, GW4194-SOJ-DC-B_Silkscreen.gbo, GW4194-SOJ-DC-Edge_Cuts.gm1, GW4194-SOJ-DC-F_Cu.gtl, GW4194-SOJ-DC-F_Mask.gts, GW4194-SOJ-DC-F_Paste.gtp, GW4194-SOJ-DC-F_Silkscreen.gto]
